jonathanyaron/FSO_Digital_Communication/README.md

# FSO_Digital_Communication
#  Optical Digital Communication System (FSO)
## Free-Space Optical (FSO) Link via LED and Photodiode

### Project Summary
This is a low-cost, robust **Free-Space Optical (FSO) communication system**  designed to transmit ASCII data reliably between microcontrollers.

The core challenge addressed was **photodiode saturation** from ambient light (sunlight, room lights).

**Solution:** We created a **hybrid analog-digital design**  that uses:
1.  **Analog Front-End (AFE):** To clean and amplify the signal.
2.  **Embedded Software:** To intelligently decode the data.

---

##  Hardware Design (The Analog Circuit)

The receiver uses a multi-stage OpAmp circuit to process the light signal.

* **TIA (Transimpedance Amplifier):** Converts the weak current from the photodiode into a strong voltage signal.
* **AC Coupling:** A capacitor ($C_2$) **blocks the DC signal** caused by constant ambient light, allowing only the fast data pulses (AC) to pass through. This is the key to immunity!
* **Active Low-Pass Filter:** This second OpAmp stage boosts the signal ($\approx 6.5x$) and removes high-frequency noise to clean the data pulses.

---

##  Software & Decoding

The system's intelligence is in the Arduino code, which handles communication timing and signal interpretation.

* **RZ-like Protocol:** A custom timing protocol ensures that the data pulses stay intact through the AC-coupled circuit.
* **Adaptive Thresholding:** Instead of a fixed hardware threshold, the software dynamically **calibrates itself** by measuring the ambient noise floor ($avg\_val$).
    * Data is detected when the signal is clearly above the current noise floor ($ADC > avg\_val + THRESHOLD$).
    * This ensures **stable operation** even when room lighting changes.
* **Performance:** Achieved reliable transmission at $15\,ms/bit$ ($\approx 66$ baud).

---

## 📁 Project Files

* **Full Report:** [[Download Full Report (PDF)](https://github.com/jonathanyaron/FSO_Digital_Communication/blob/main/Report%20with%20Physical%20Setup.pdf)](Documentation/Report with Physical Setup.pdf)
* **Schematics:** [[Receiver Schematic](https://github.com/jonathanyaron/FSO_Digital_Communication/blob/main/receiver.png)](Hardware/receiver.png) and [[Transmitter Schematic](https://github.com/jonathanyaron/FSO_Digital_Communication/blob/main/transmitter.png.png)](Hardware/transmitter.png)
* **Code:** [[Arduino Source Files](https://github.com/jonathanyaron/FSO_Digital_Communication/blob/main/transmitter_nov21a.ino)](SRC/)
