jonathanyaron/FSO_Digital_Communication/receiver.png

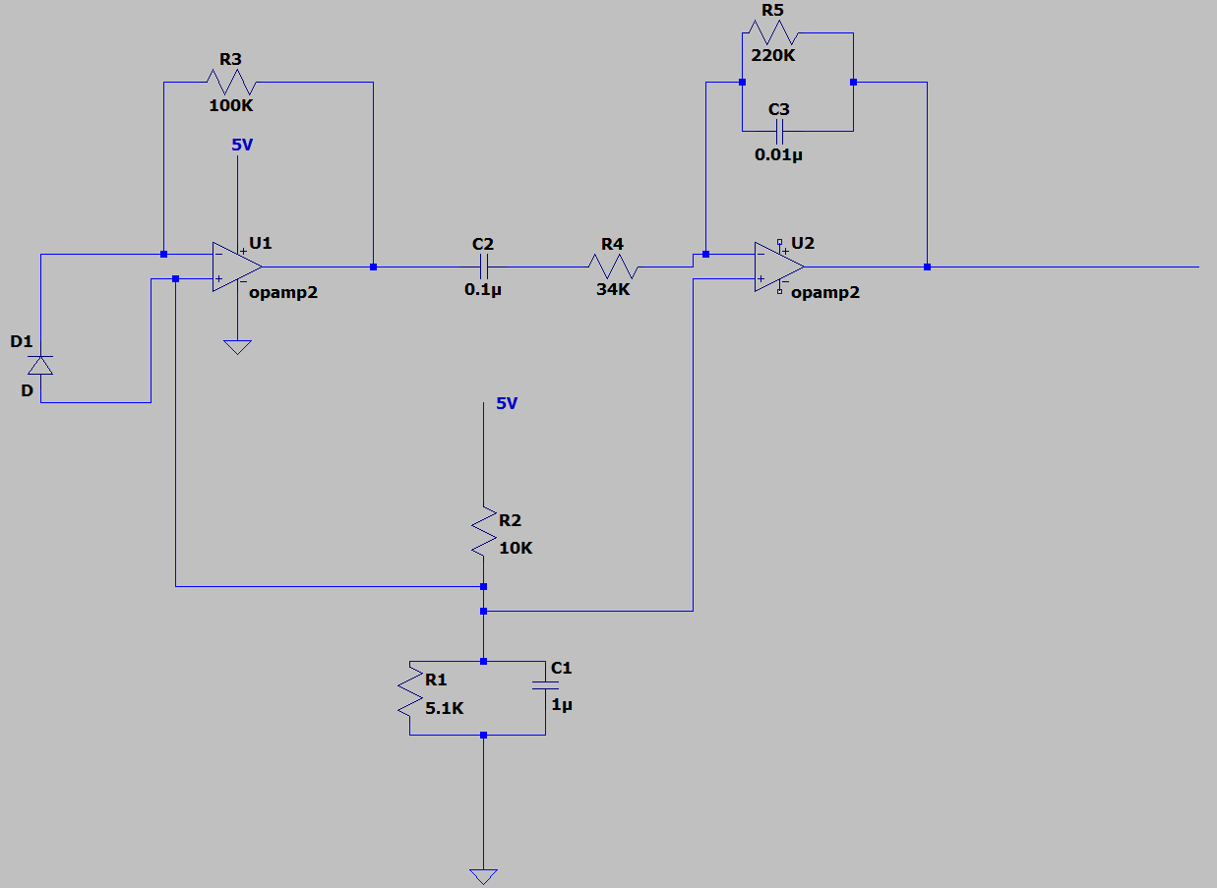
receiver.png
