jonathanyaron/FSO_Digital_Communication/transmitter.png.png

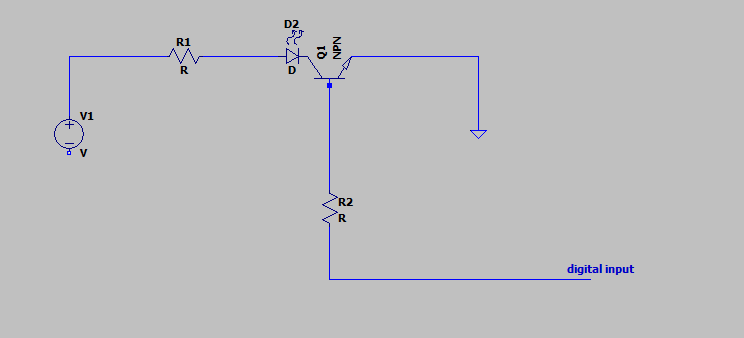
transmitter.png.png
